jensma-de/Neoware-Eon-CA2-PISA-riser/schematics.pdf

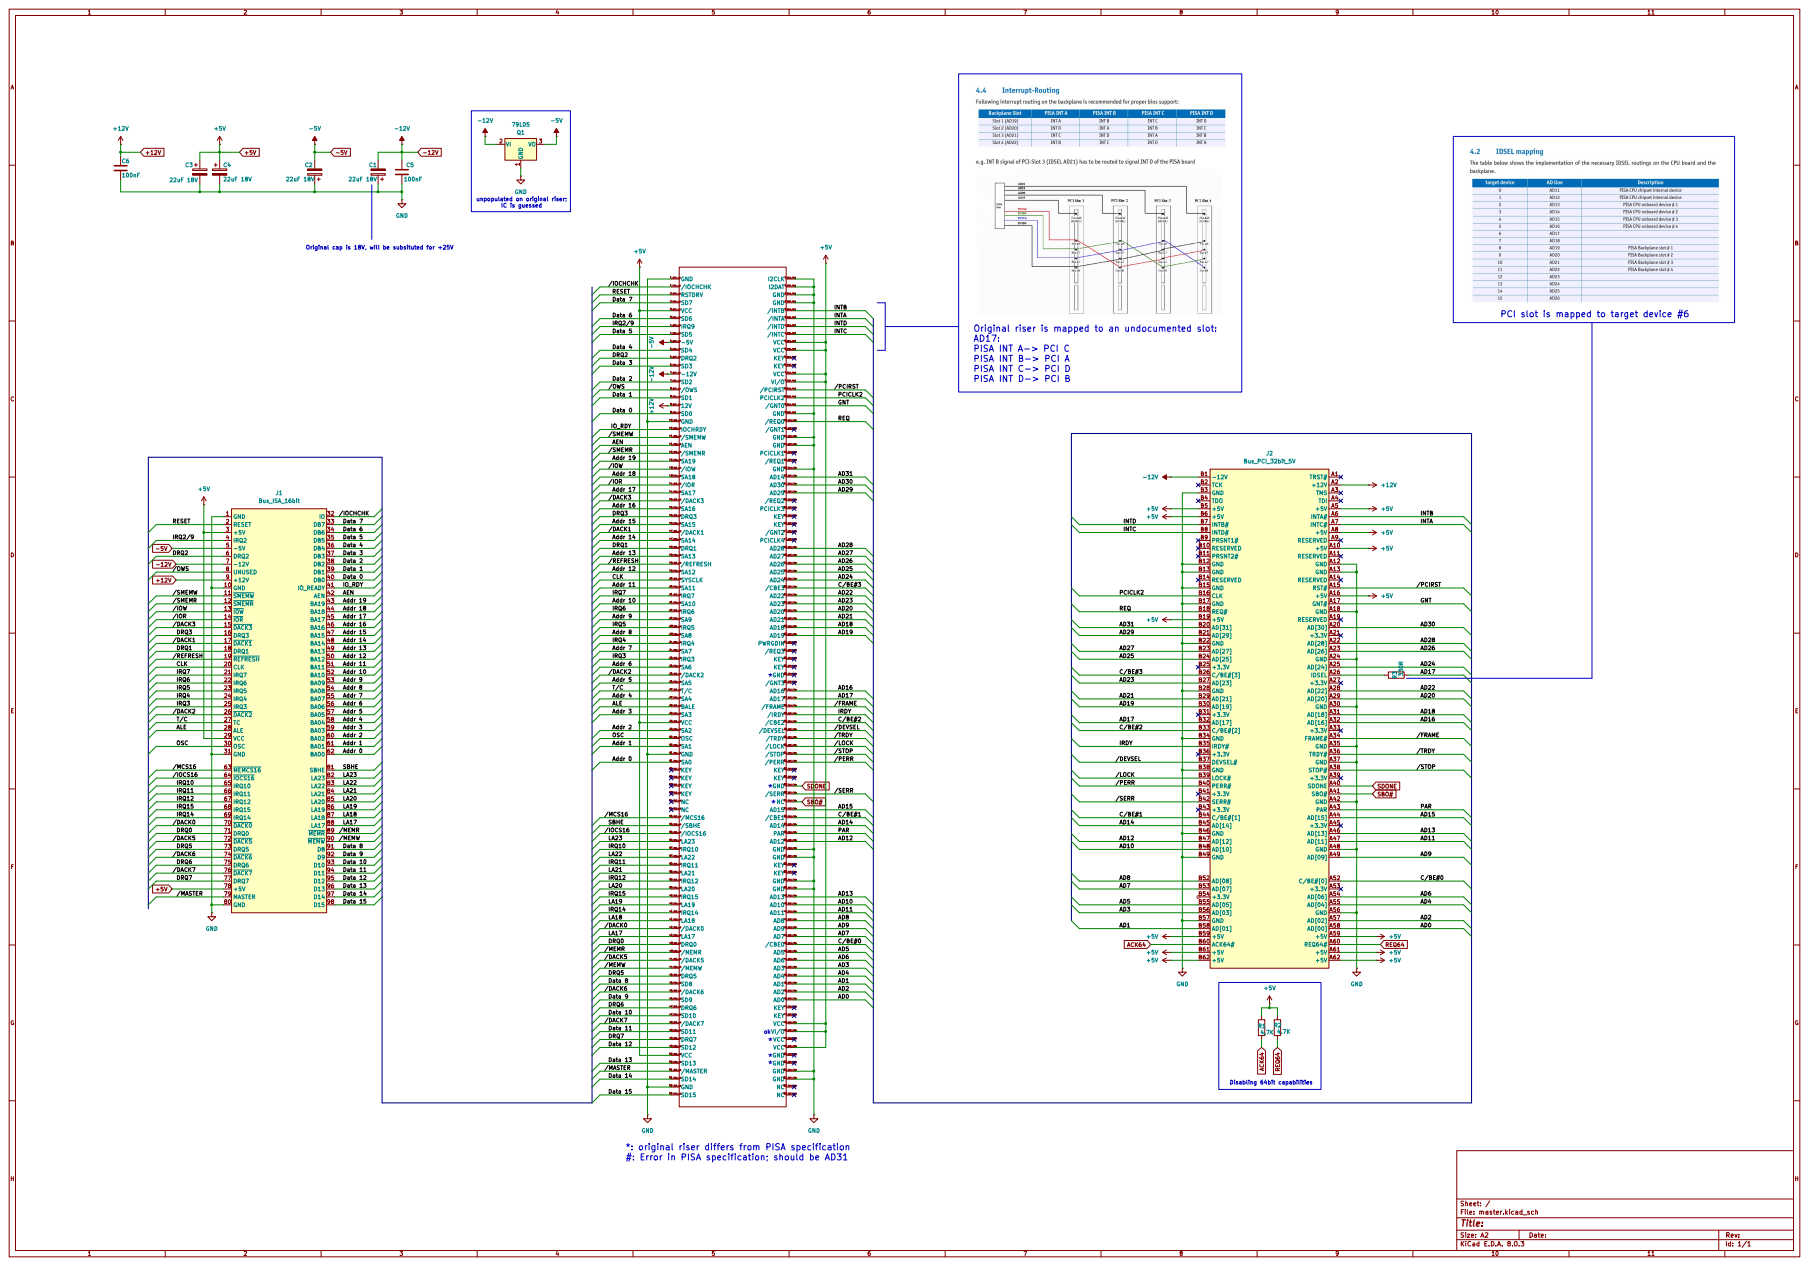
[picture p3: page 1]
