jensma-de/Neoware-Eon-CA2-PISA-riser/master.kicad_pcb

## KiCad design master.kicad_pcb (2024-10-12)

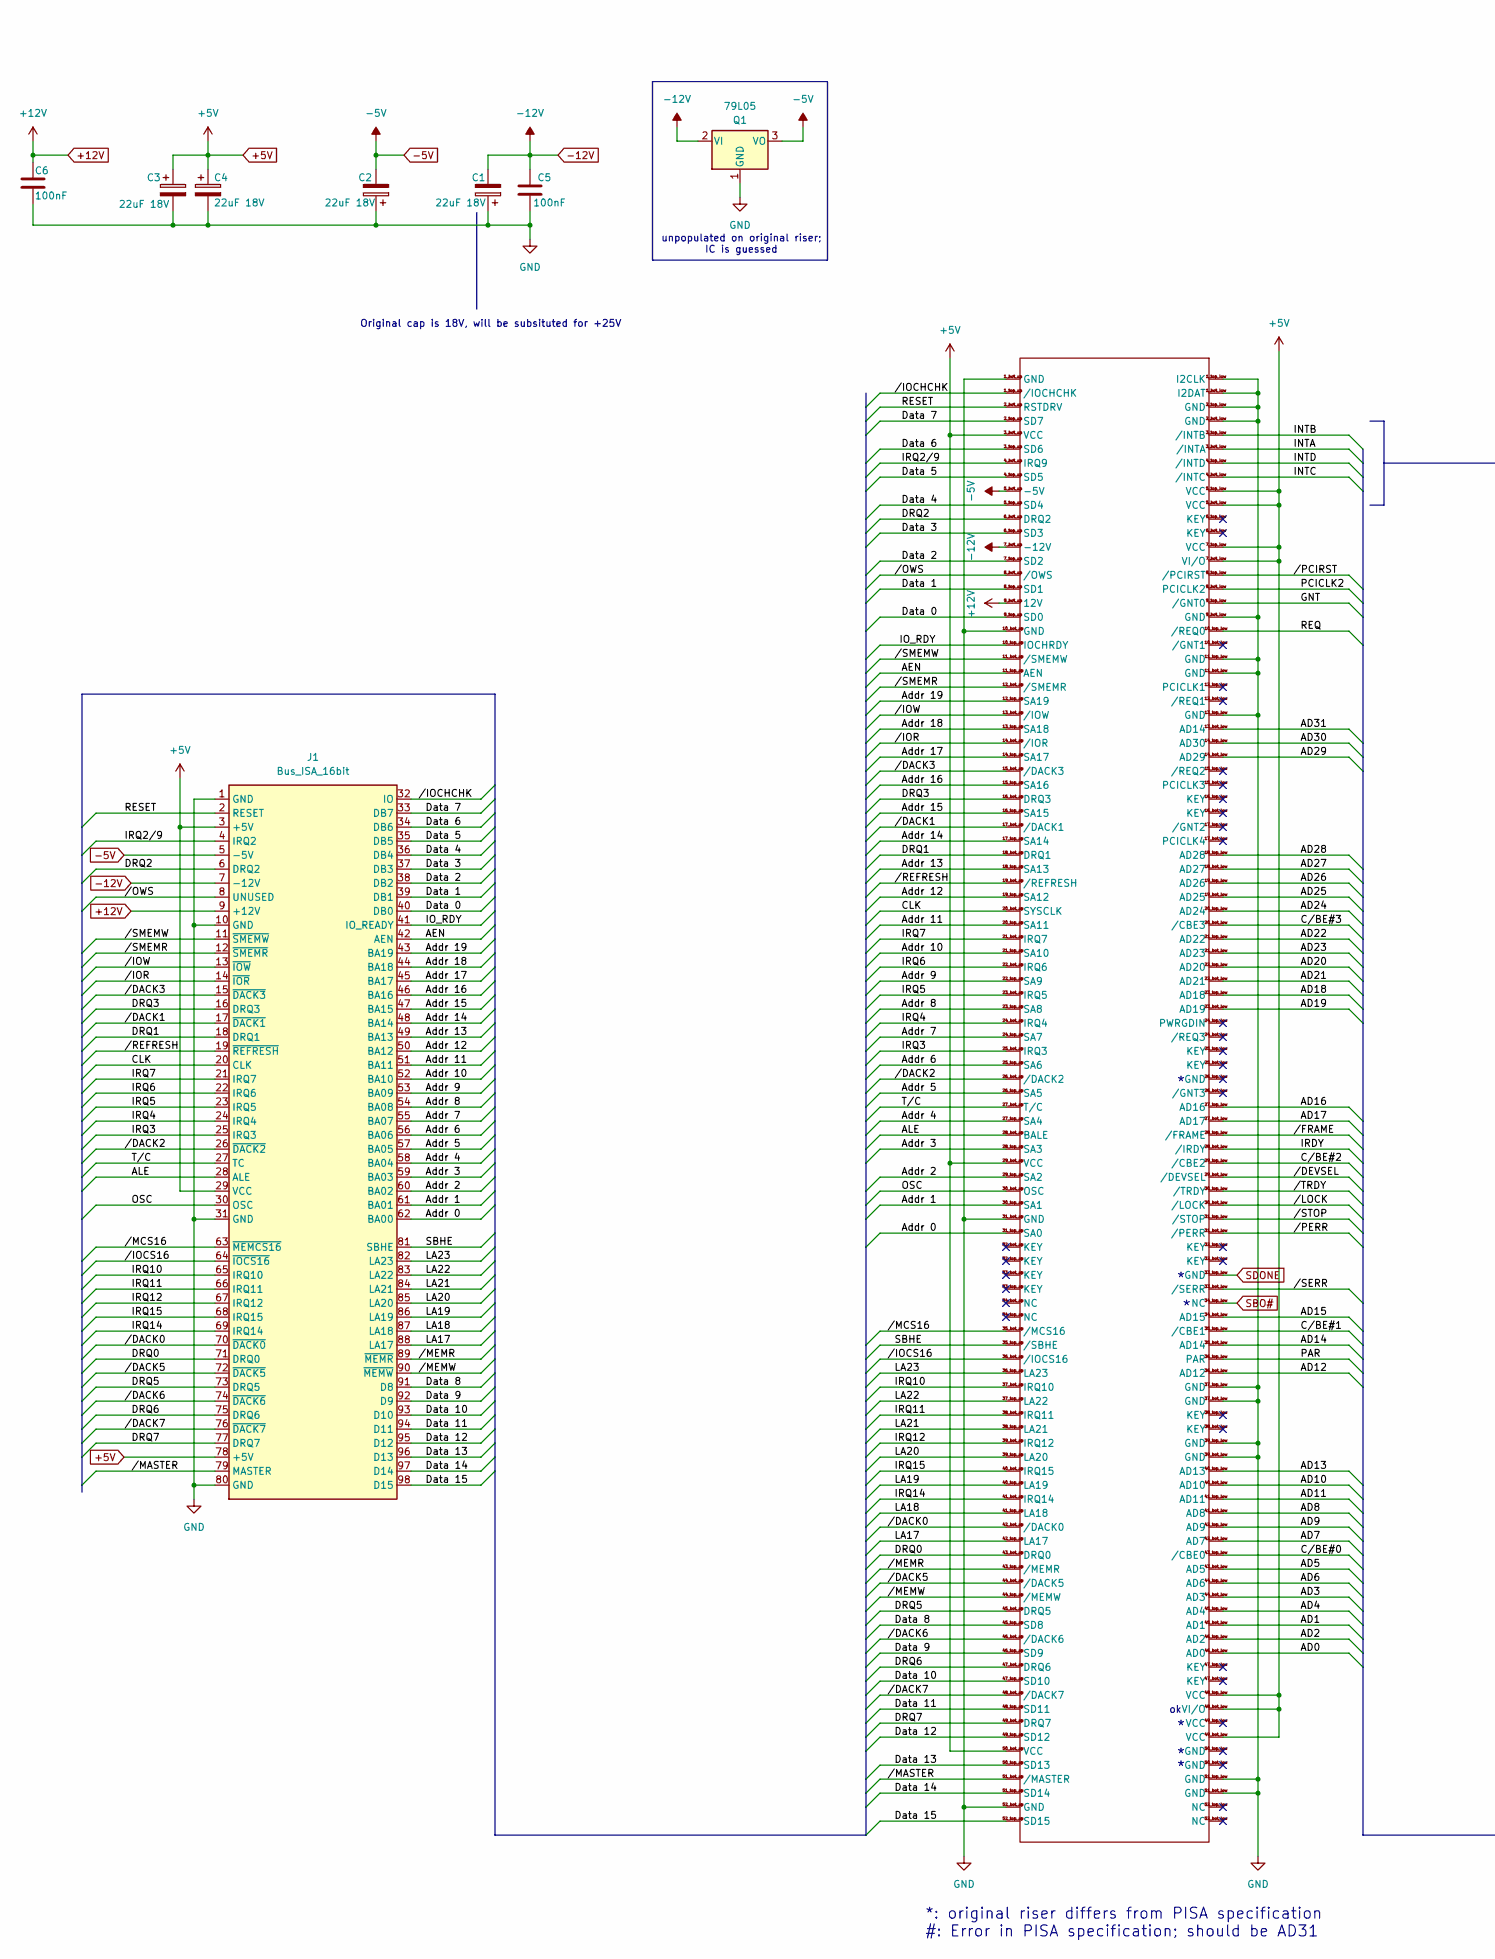
[picture p4: schematic master.kicad_sch, part in row 1, column 1]

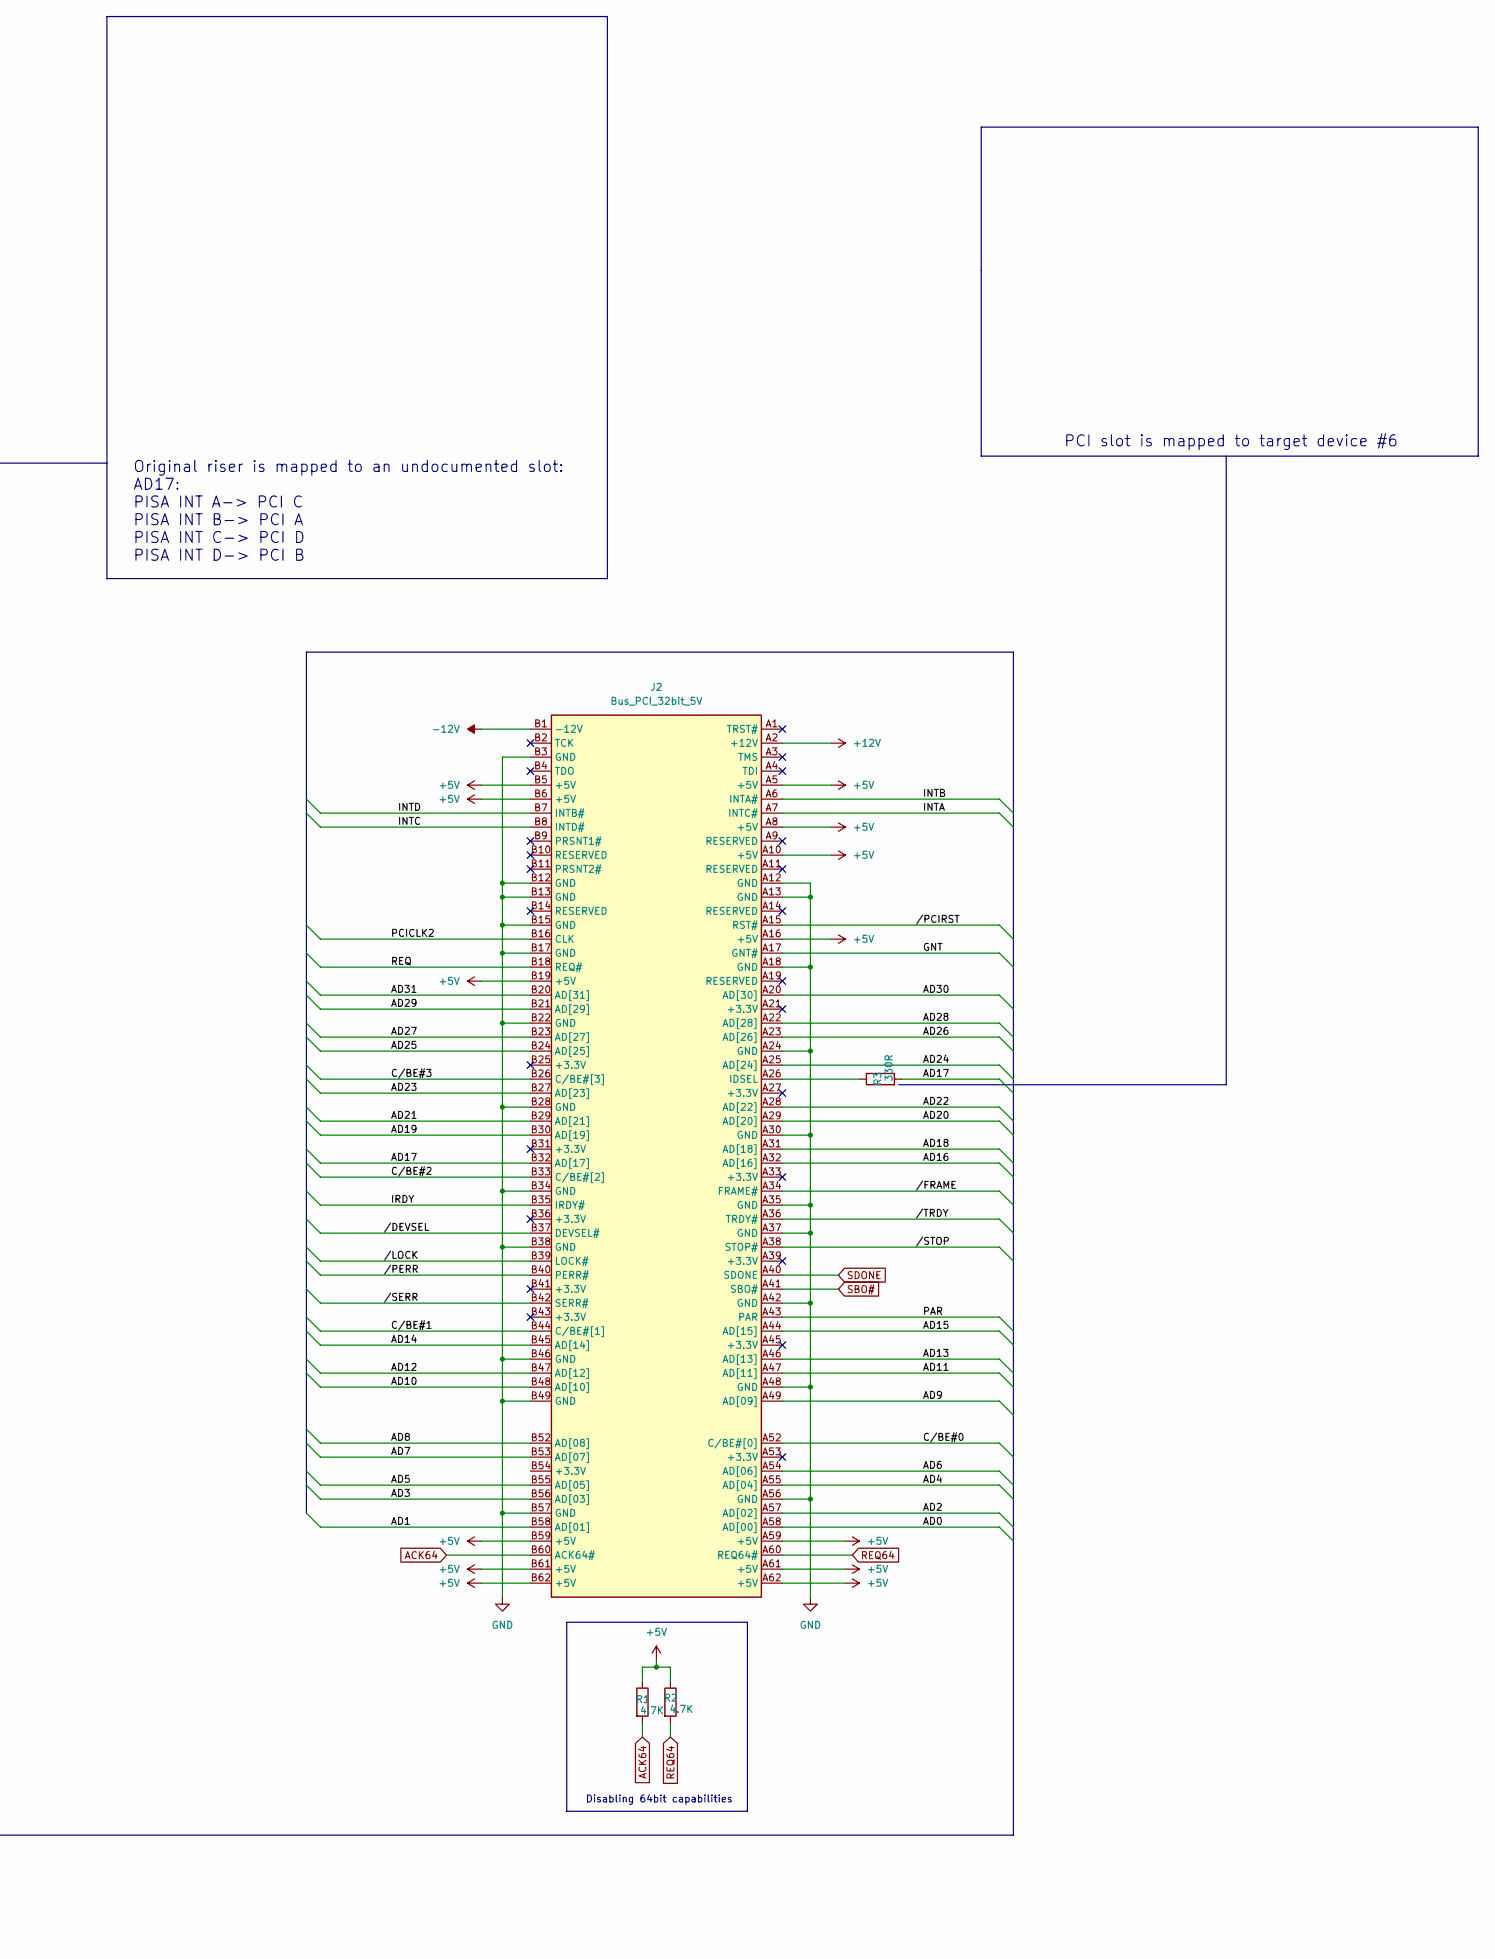
[picture p5: schematic master.kicad_sch, part in row 1, column 2]

Parts:
C1, C2, C3, C4: 22uF 18V; CP_Radial_D5.0mm_P2.00mm
C5, C6: 100nF; C_Disc_D5.0mm_W2.5mm_P5.00mm
J1: Bus_ISA_16bit; ISA 98PIN
J2: Bus_PCI_32bit_5V; PCI
Q1: 79L05; TO-92_Inline_Wide
R1, R2: 4.7K; R_Axial_DIN0207_L6.3mm_D2.5mm_P10.16mm_Horizontal
R3: 330R; R_Axial_DIN0207_L6.3mm_D2.5mm_P10.16mm_Horizontal
U1: EISA

Connections:
+5V: C3.1, C4.1, J1.3 (+5V), J1.29 (VCC), J1.78 (+5V), J2.A5 (+5V), J2.A8 (+5V), J2.A10 (+5V), J2.A16 (+5V), J2.A59 (+5V), J2.A61 (+5V), J2.A62 (+5V), J2.B5 (+5V), J2.B6 (+5V), J2.B19 (+5V), J2.B59 (+5V), J2.B61 (+5V), J2.B62 (+5V), R1.1, R2.1, U1.3_bot_up (VCC), U1.5_bot_low (VCC), U1.5_top_low (VCC), U1.7_bot_low (VI/O), U1.7_top_low (VCC), U1.29_bot_up (VCC), U1.48_bot_low (VI/O), U1.48_top_low (VCC), U1.49_bot_low (VCC), U1.50_bot_up (VCC)
+12V: C6.1, J1.9 (+12V), J2.A2 (+12V), U1.9_bot_up (12V)
-5V: C2.2, J1.5 (-5V), Q1.3 (VO), U1.5_bot_up (-5V)
-12V: C1.2, C5.1, J1.7 (-12V), J2.B1 (-12V), Q1.2 (VI), U1.7_bot_up (-12V)
/AD0: J2.A58 (AD[00]), U1.46_bot_low (AD0)
/AD1: J2.B58 (AD[01]), U1.45_bot_low (AD1)
/AD2: J2.A57 (AD[02]), U1.46_top_low (AD2)
/AD3: J2.B56 (AD[03]), U1.44_bot_low (AD3)
/AD4: J2.A55 (AD[04]), U1.45_top_low (AD4)
/AD5: J2.B55 (AD[05]), U1.43_bot_low (AD5)
/AD6: J2.A54 (AD[06]), U1.44_top_low (AD6)
/AD7: J2.B53 (AD[07]), U1.42_bot_low (AD7)
/AD8: J2.B52 (AD[08]), U1.41_bot_low (AD8)
/AD9: J2.A49 (AD[09]), U1.42_top_low (AD9)
/AD10: J2.B48 (AD[10]), U1.40_bot_low (AD10)
/AD11: J2.A47 (AD[11]), U1.41_top_low (AD11)
/AD12: J2.B47 (AD[12]), U1.36_bot_low (AD12)
/AD13: J2.A46 (AD[13]), U1.40_top_low (AD13)
/AD14: J2.B45 (AD[14]), U1.35_bot_low (AD14)
/AD15: J2.A44 (AD[15]), U1.34_bot_low (AD15)
/AD16: J2.A32 (AD[16]), U1.27_top_low (AD16)
/AD17: J2.B32 (AD[17]), R3.2, U1.27_bot_low (AD17)
/AD18: J2.A31 (AD[18]), U1.23_top_low (AD18)
/AD19: J2.B30 (AD[19]), U1.23_bot_low (AD19)
/AD20: J2.A29 (AD[20]), U1.22_top_low (AD20)
/AD21: J2.B29 (AD[21]), U1.22_bot_low (AD21)
/AD22: J2.A28 (AD[22]), U1.21_top_low (AD22)
/AD23: J2.B27 (AD[23]), U1.21_bot_low (AD23)
/AD24: J2.A25 (AD[24]), U1.20_top_low (AD24)
/AD25: J2.B24 (AD[25]), U1.19_bot_low (AD25)
/AD26: J2.A23 (AD[26]), U1.19_top_low (AD26)
/AD27: J2.B23 (AD[27]), U1.18_bot_low (AD27)
/AD28: J2.A22 (AD[28]), U1.18_top_low (AD28)
/AD29: J2.B21 (AD[29]), U1.14_bot_low (AD29)
/AD30: J2.A20 (AD[30]), U1.14_top_low (AD30)
/AD31: J2.B20 (AD[31]), U1.13_bot_low (AD14)
/AEN: J1.42 (AEN), U1.11_top_up (AEN)
/ALE: J1.28 (ALE), U1.28_bot_up (BALE)
/Addr 0: J1.62 (BA00), U1.31_top_up (SA0)
/Addr 1: J1.61 (BA01), U1.30_top_up (SA1)
/Addr 2: J1.60 (BA02), U1.29_top_up (SA2)
/Addr 3: J1.59 (BA03), U1.28_top_up (SA3)
/Addr 4: J1.58 (BA04), U1.27_top_up (SA4)
/Addr 5: J1.57 (BA05), U1.26_top_up (SA5)
/Addr 6: J1.56 (BA06), U1.25_top_up (SA6)
/Addr 7: J1.55 (BA07), U1.24_top_up (SA7)
/Addr 8: J1.54 (BA08), U1.23_top_up (SA8)
/Addr 9: J1.53 (BA09), U1.22_top_up (SA9)
/Addr 10: J1.52 (BA10), U1.21_top_up (SA10)
/Addr 11: J1.51 (BA11), U1.20_top_up (SA11)
/Addr 12: J1.50 (BA12), U1.19_top_up (SA12)
/Addr 13: J1.49 (BA13), U1.18_top_up (SA13)
/Addr 14: J1.48 (BA14), U1.17_top_up (SA14)
/Addr 15: J1.47 (BA15), U1.16_top_up (SA15)
/Addr 16: J1.46 (BA16), U1.15_top_up (SA16)
/Addr 17: J1.45 (BA17), U1.14_top_up (SA17)
/Addr 18: J1.44 (BA18), U1.13_top_up (SA18)
/Addr 19: J1.43 (BA19), U1.12_top_up (SA19)
/CLK: J1.20 (CLK), U1.20_bot_up (SYSCLK)
/C/BE#0: J2.A52 (C/BE#[0]), U1.43_top_low (/CBE0)
/C/BE#1: J2.B44 (C/BE#[1]), U1.35_top_low (/CBE1)
/C/BE#2: J2.B33 (C/BE#[2]), U1.29_top_low (/CBE2)
/C/BE#3: J2.B26 (C/BE#[3]), U1.20_bot_low (/CBE3)
/DRQ0: J1.71 (DRQ0), U1.43_bot_up (DRQ0)
/DRQ1: J1.18 (DRQ1), U1.18_bot_up (DRQ1)
/DRQ2: J1.6 (DRQ2), U1.6_bot_up (DRQ2)
/DRQ3: J1.16 (DRQ3), U1.16_bot_up (DRQ3)
/DRQ5: J1.73 (DRQ5), U1.45_bot_up (DRQ5)
/DRQ6: J1.75 (DRQ6), U1.47_bot_up (DRQ6)
/DRQ7: J1.77 (DRQ7), U1.49_bot_up (DRQ7)
/Data 0: J1.40 (DB0), U1.9_top_up (SD0)
/Data 1: J1.39 (DB1), U1.8_top_up (SD1)
/Data 2: J1.38 (DB2), U1.7_top_up (SD2)
/Data 3: J1.37 (DB3), U1.6_top_up (SD3)
/Data 4: J1.36 (DB4), U1.5_top_up (SD4)
/Data 5: J1.35 (DB5), U1.4_top_up (SD5)
/Data 6: J1.34 (DB6), U1.3_top_up (SD6)
/Data 7: J1.33 (DB7), U1.2_top_up (SD7)
/Data 8: J1.91 (D8), U1.45_top_up (SD8)
/Data 9: J1.92 (D9), U1.46_top_up (SD9)
/Data 10: J1.93 (D10), U1.47_top_up (SD10)
/Data 11: J1.94 (D11), U1.48_top_up (SD11)
/Data 12: J1.95 (D12), U1.49_top_up (SD12)
/Data 13: J1.96 (D13), U1.50_top_up (SD13)
/Data 14: J1.97 (D14), U1.51_top_up (SD14)
/Data 15: J1.98 (D15), U1.52_top_up (SD15)
/GNT: J2.A17 (GNT#), U1.9_top_low (/GNT0)
/INTA: J2.A7 (INTC#), U1.3_bot_low (/INTA)
/INTB: J2.A6 (INTA#), U1.3_top_low (/INTB)
/INTC: J2.B8 (INTD#), U1.4_bot_low (/INTC)
/INTD: J2.B7 (INTB#), U1.4_top_low (/INTD)
/IO_RDY: J1.41 (IO_READY), U1.10_top_up (IOCHRDY)
/IRDY: J2.B35 (IRDY#), U1.28_bot_low (/IRDY)
/IRQ2/9: J1.4 (IRQ2), U1.4_bot_up (IRQ9)
/IRQ3: J1.25 (IRQ3), U1.25_bot_up (IRQ3)
/IRQ4: J1.24 (IRQ4), U1.24_bot_up (IRQ4)
/IRQ5: J1.23 (IRQ5), U1.23_bot_up (IRQ5)
/IRQ6: J1.22 (IRQ6), U1.22_bot_up (IRQ6)
/IRQ7: J1.21 (IRQ7), U1.21_bot_up (IRQ7)
/IRQ10: J1.65 (IRQ10), U1.37_bot_up (IRQ10)
/IRQ11: J1.66 (IRQ11), U1.38_bot_up (IRQ11)
/IRQ12: J1.67 (IRQ12), U1.39_bot_up (IRQ12)
/IRQ14: J1.69 (IRQ14), U1.41_bot_up (IRQ14)
/IRQ15: J1.68 (IRQ15), U1.40_bot_up (IRQ15)
/LA17: J1.88 (LA17), U1.42_top_up (LA17)
/LA18: J1.87 (LA18), U1.41_top_up (LA18)
/LA19: J1.86 (LA19), U1.40_top_up (LA19)
/LA20: J1.85 (LA20), U1.39_top_up (LA20)
/LA21: J1.84 (LA21), U1.38_top_up (LA21)
/LA22: J1.83 (LA22), U1.37_top_up (LA22)
/LA23: J1.82 (LA23), U1.36_top_up (LA23)
/OSC: J1.30 (OSC), U1.30_bot_up (OSC)
/PAR: J2.A43 (PAR), U1.36_top_low (PAR)
/PCICLK2: J2.B16 (CLK), U1.8_bot_low (PCICLK2)
/REQ: J2.B18 (REQ#), U1.10_top_low (/REQ0)
/RESET: J1.2 (RESET), U1.2_bot_up (RSTDRV)
/SBHE: J1.81 (SBHE), U1.35_top_up (/SBHE)
/T/C: J1.27 (TC), U1.27_bot_up (T/C)
//DACK0: J1.70 (~DACK0), U1.42_bot_up (/DACK0)
//DACK1: J1.17 (~DACK1), U1.17_bot_up (/DACK1)
//DACK2: J1.26 (~DACK2), U1.26_bot_up (/DACK2)
//DACK3: J1.15 (~DACK3), U1.15_bot_up (/DACK3)
//DACK5: J1.72 (~DACK5), U1.44_bot_up (/DACK5)
//DACK6: J1.74 (~DACK6), U1.46_bot_up (/DACK6)
//DACK7: J1.76 (~DACK7), U1.48_bot_up (/DACK7)
//DEVSEL: J2.B37 (DEVSEL#), U1.29_bot_low (/DEVSEL)
//FRAME: J2.A34 (FRAME#), U1.28_top_low (/FRAME)
//IOCHCHK: J1.32 (IO), U1.1_top_up (/IOCHCHK)
//IOCS16: J1.64 (~IOCS16), U1.36_bot_up (/IOCS16)
//IOR: J1.14 (~IOR), U1.14_bot_up (/IOR)
//IOW: J1.13 (~IOW), U1.13_bot_up (/IOW)
//LOCK: J2.B39 (LOCK#), U1.30_bot_low (/LOCK)
//MASTER: J1.79 (MASTER), U1.51_bot_up (/MASTER)
//MCS16: J1.63 (~MEMCS16), U1.35_bot_up (/MCS16)
//MEMR: J1.89 (~MEMR), U1.43_top_up (/MEMR)
//MEMW: J1.90 (~MEMW), U1.44_top_up (/MEMW)
//OWS: J1.8 (UNUSED), U1.8_bot_up (/OWS)
//PCIRST: J2.A15 (RST#), U1.8_top_low (/PCIRST)
//PERR: J2.B40 (PERR#), U1.31_bot_low (/PERR)
//REFRESH: J1.19 (~REFRESH), U1.19_bot_up (/REFRESH)
//SERR: J2.B42 (SERR#), U1.33_bot_low (/SERR)
//SMEMR: J1.12 (~SMEMR), U1.12_bot_up (/SMEMR)
//SMEMW: J1.11 (~SMEMW), U1.11_bot_up (/SMEMW)
//STOP: J2.A38 (STOP#), U1.31_top_low (/STOP)
//TRDY: J2.A36 (TRDY#), U1.30_top_low (/TRDY)
ACK64: J2.B60 (ACK64#), R1.2
GND: C1.1, C2.1, C3.2, C4.2, C5.2, C6.2, J1.1 (GND), J1.10 (GND), J1.31 (GND), J1.80 (GND), J2.A12 (GND), J2.A13 (GND), J2.A18 (GND), J2.A24 (GND), J2.A30 (GND), J2.A35 (GND), J2.A37 (GND), J2.A42 (GND), J2.A48 (GND), J2.A56 (GND), J2.B3 (GND), J2.B12 (GND), J2.B13 (GND), J2.B15 (GND), J2.B17 (GND), J2.B22 (GND), J2.B28 (GND), J2.B34 (GND), J2.B38 (GND), J2.B46 (GND), J2.B49 (GND), J2.B57 (GND), Q1.1 (GND), U1.1_bot_low (I2DAT), U1.1_bot_up (GND), U1.1_top_low (I2CLK), U1.2_bot_low (GND), U1.2_top_low (GND), U1.9_bot_low (GND), U1.10_bot_up (GND), U1.11_bot_low (GND), U1.11_top_low (GND), U1.13_top_low (GND), U1.31_bot_up (GND), U1.37_bot_low (GND), U1.37_top_low (GND), U1.39_bot_low (GND), U1.39_top_low (GND), U1.51_bot_low (GND), U1.51_top_low (GND), U1.52_bot_up (GND)
unnamed: J2.A26 (IDSEL), R3.1
REQ64: J2.A60 (REQ64#), R2.2
SBO#: J2.A41 (SBO#), U1.34_top_low (NC)
SDONE: J2.A40 (SDONE), U1.33_top_low (GND)

Notes on the sheet:
PCI slot is mapped to target device #6
Original riser is mapped to an undocumented slot: AD17: PISA INT A-> PCI C PISA INT B-> PCI A PISA INT C-> PCI D PISA INT D-> PCI B
unpopulated on original riser; IC is guessed
Disabling 64bit capabilities
*: original riser differs from PISA specification #: Error in PISA specification; should be AD31
Original cap is 18V, will be subsituted for +25V

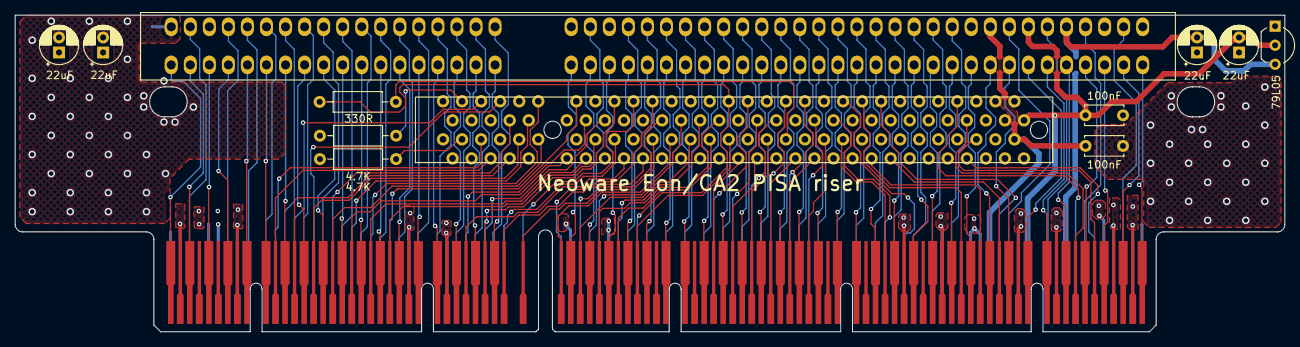
[picture p6: board master.kicad_pcb from above]

Board: 4 copper layers, 169.3 x 42.2 mm, 13 parts (0 on the bottom side), 151 nets.
